John-K/ecp5-mini/hardware/0.1.1/ecp5-mini.pdf

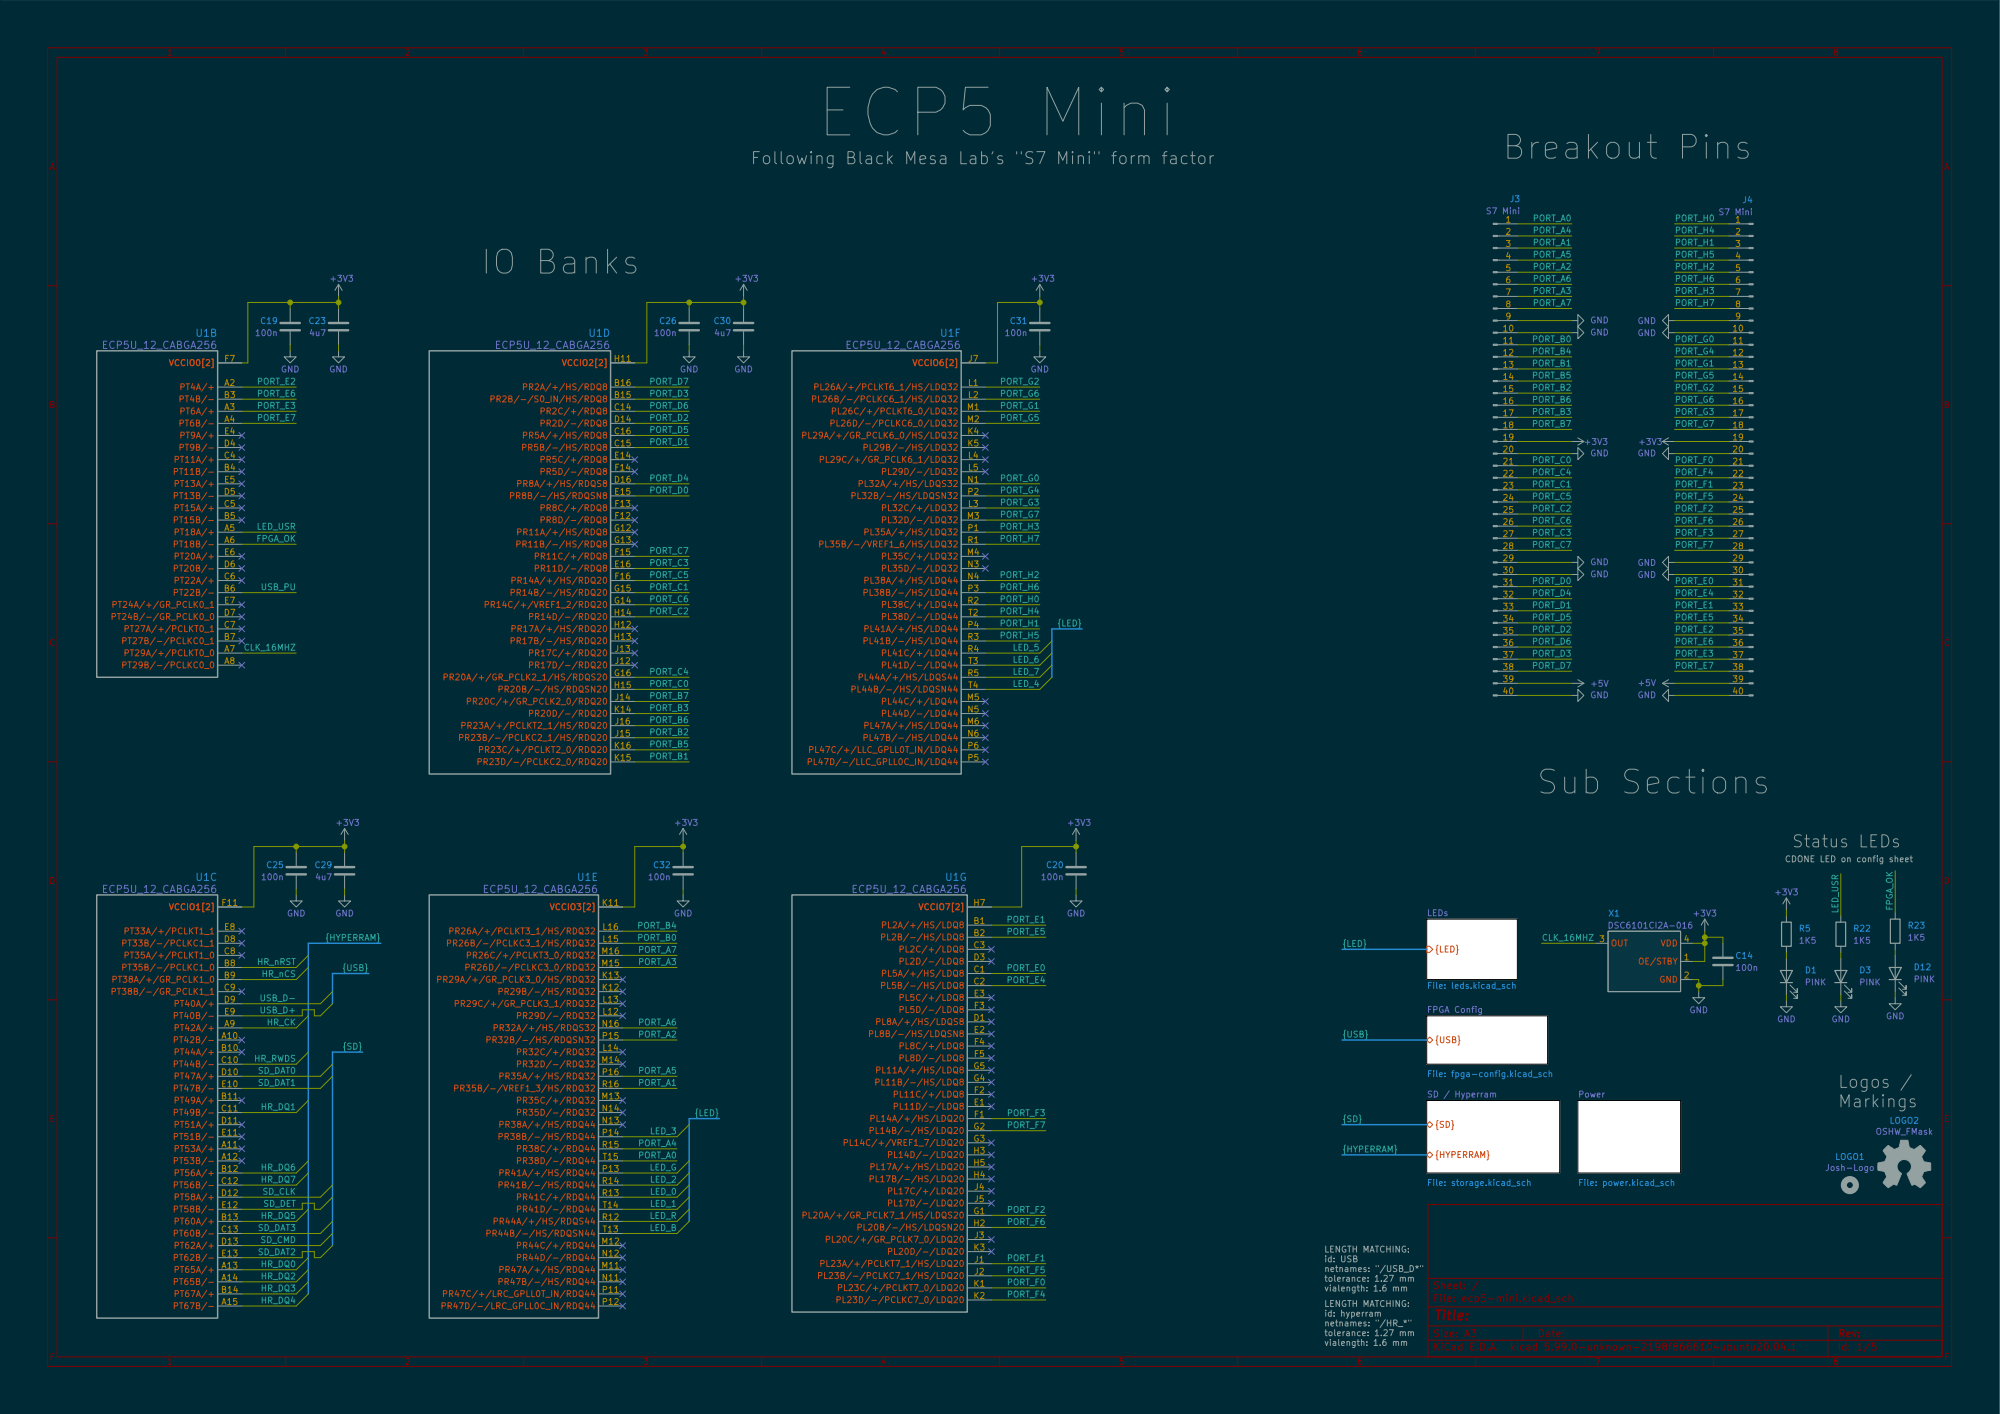
[picture p1: page 1]

Following Black Mesa Lab's "S7 Mini" form factor

CDONE LED on config sheet

{USB} LEDs File: leds.kicad_sch
File: ecp5-mini.kicad_sch Sheet: / FPGA Config

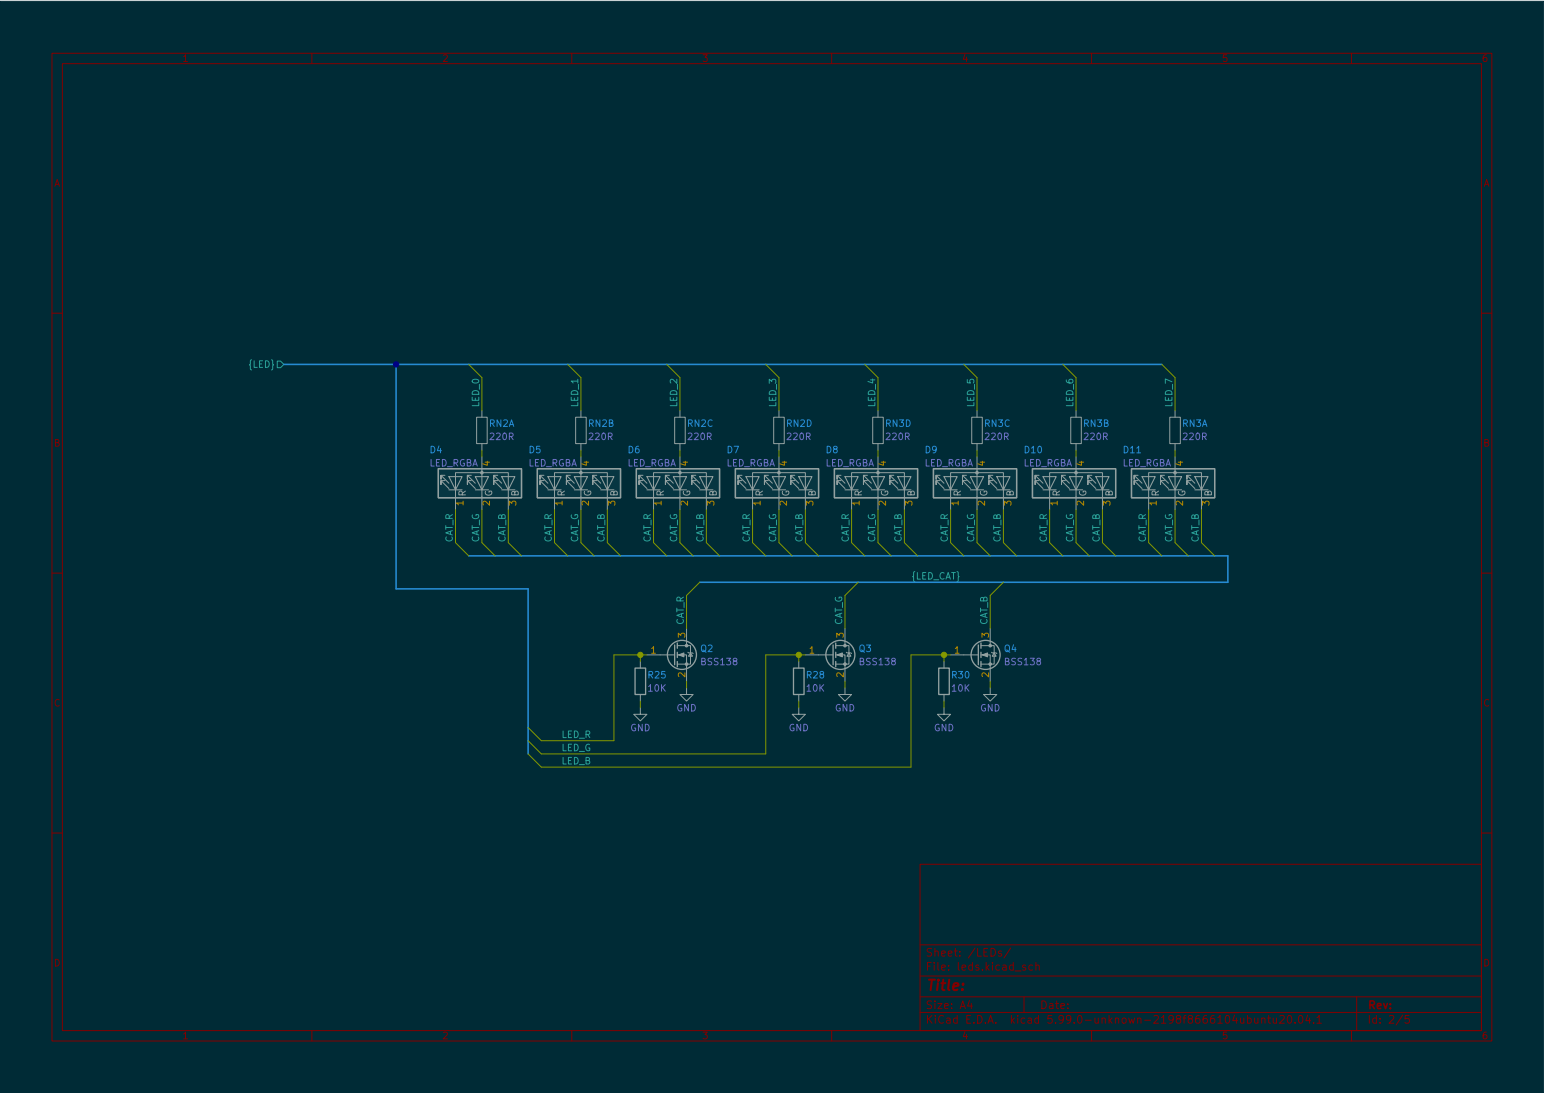
[picture p2: page 2]

2 3 Q3BSS138 GND
File: leds.kicad_sch Sheet: /LEDs/ GND

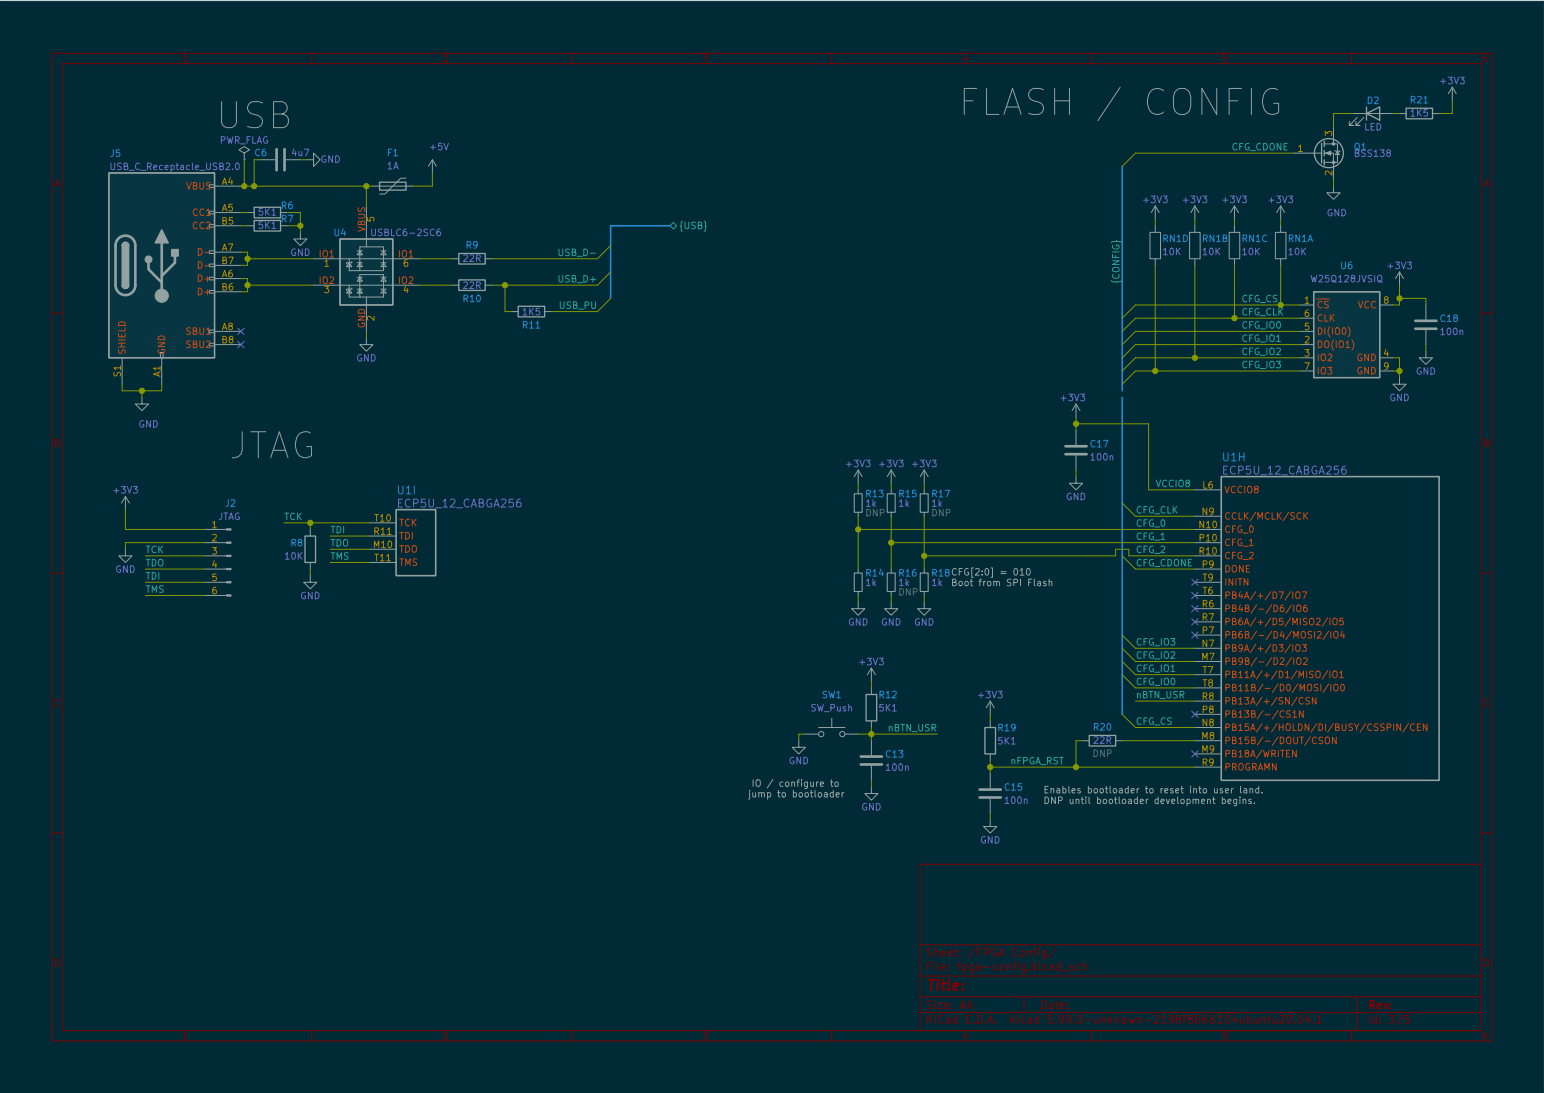
[picture p3: page 3]

CFG[2:0] = 010 Boot from SPI Flash Enables bootloader to reset into user land. DNP until bootloader development begins.

Sheet: /FPGA Config/ GND

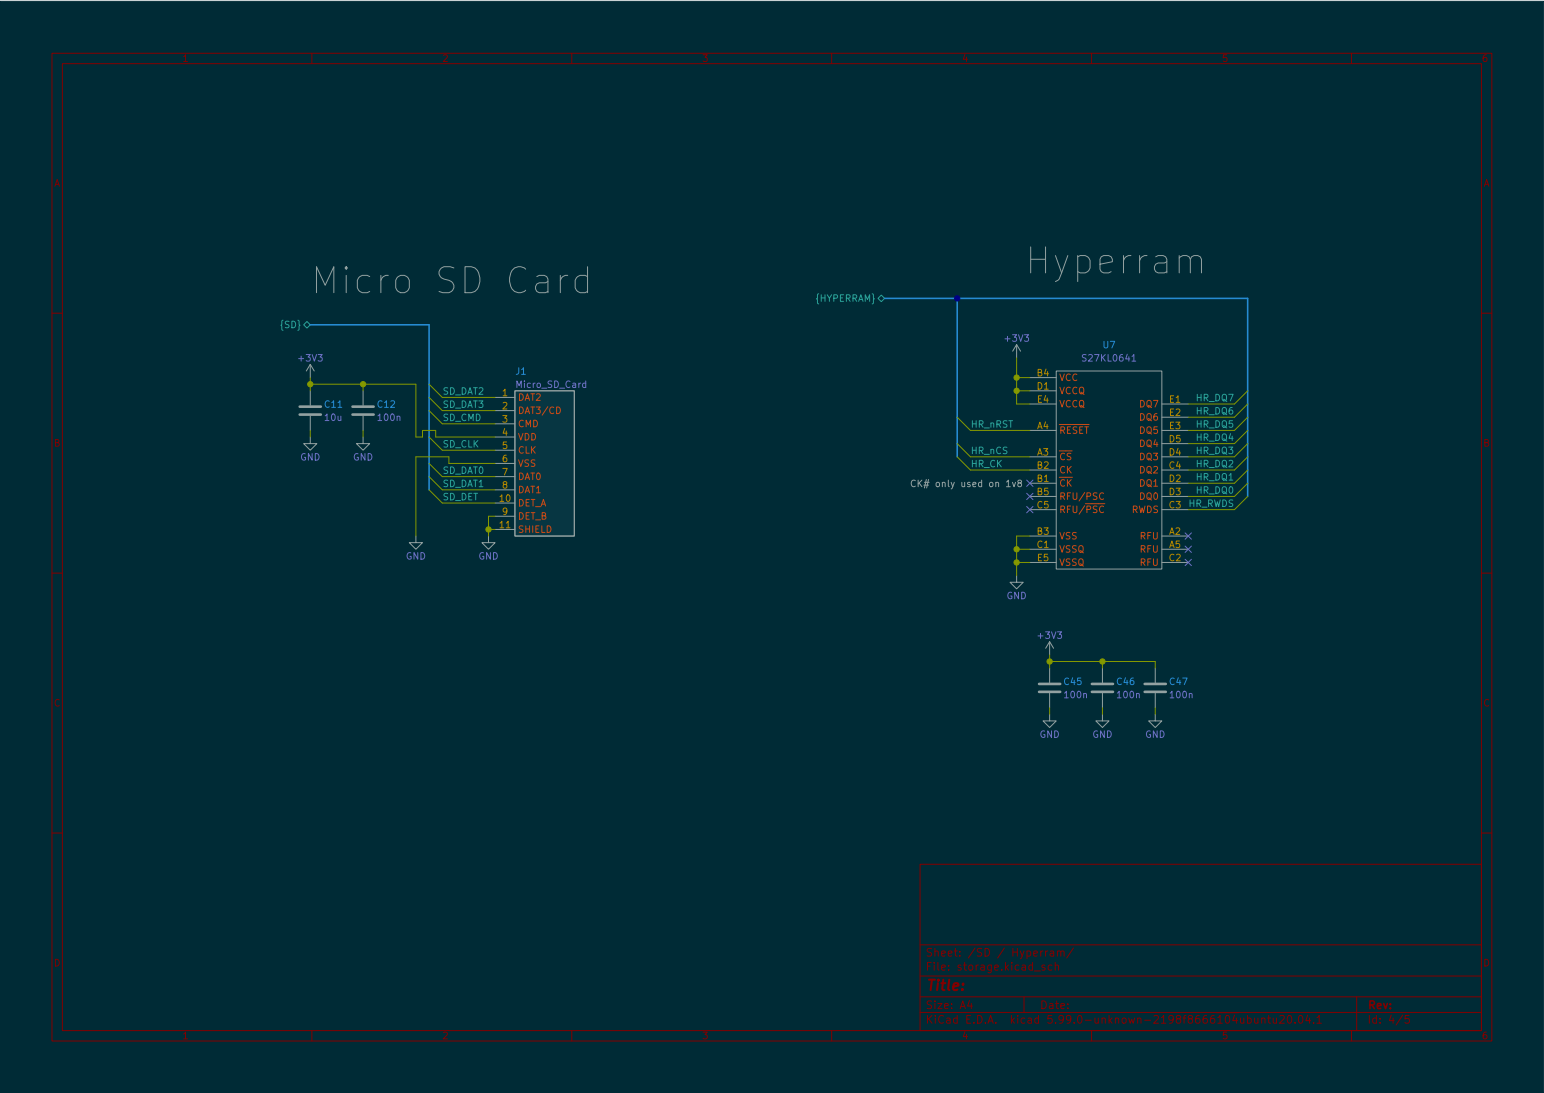
[picture p4: page 4]

CK# only used on 1v8

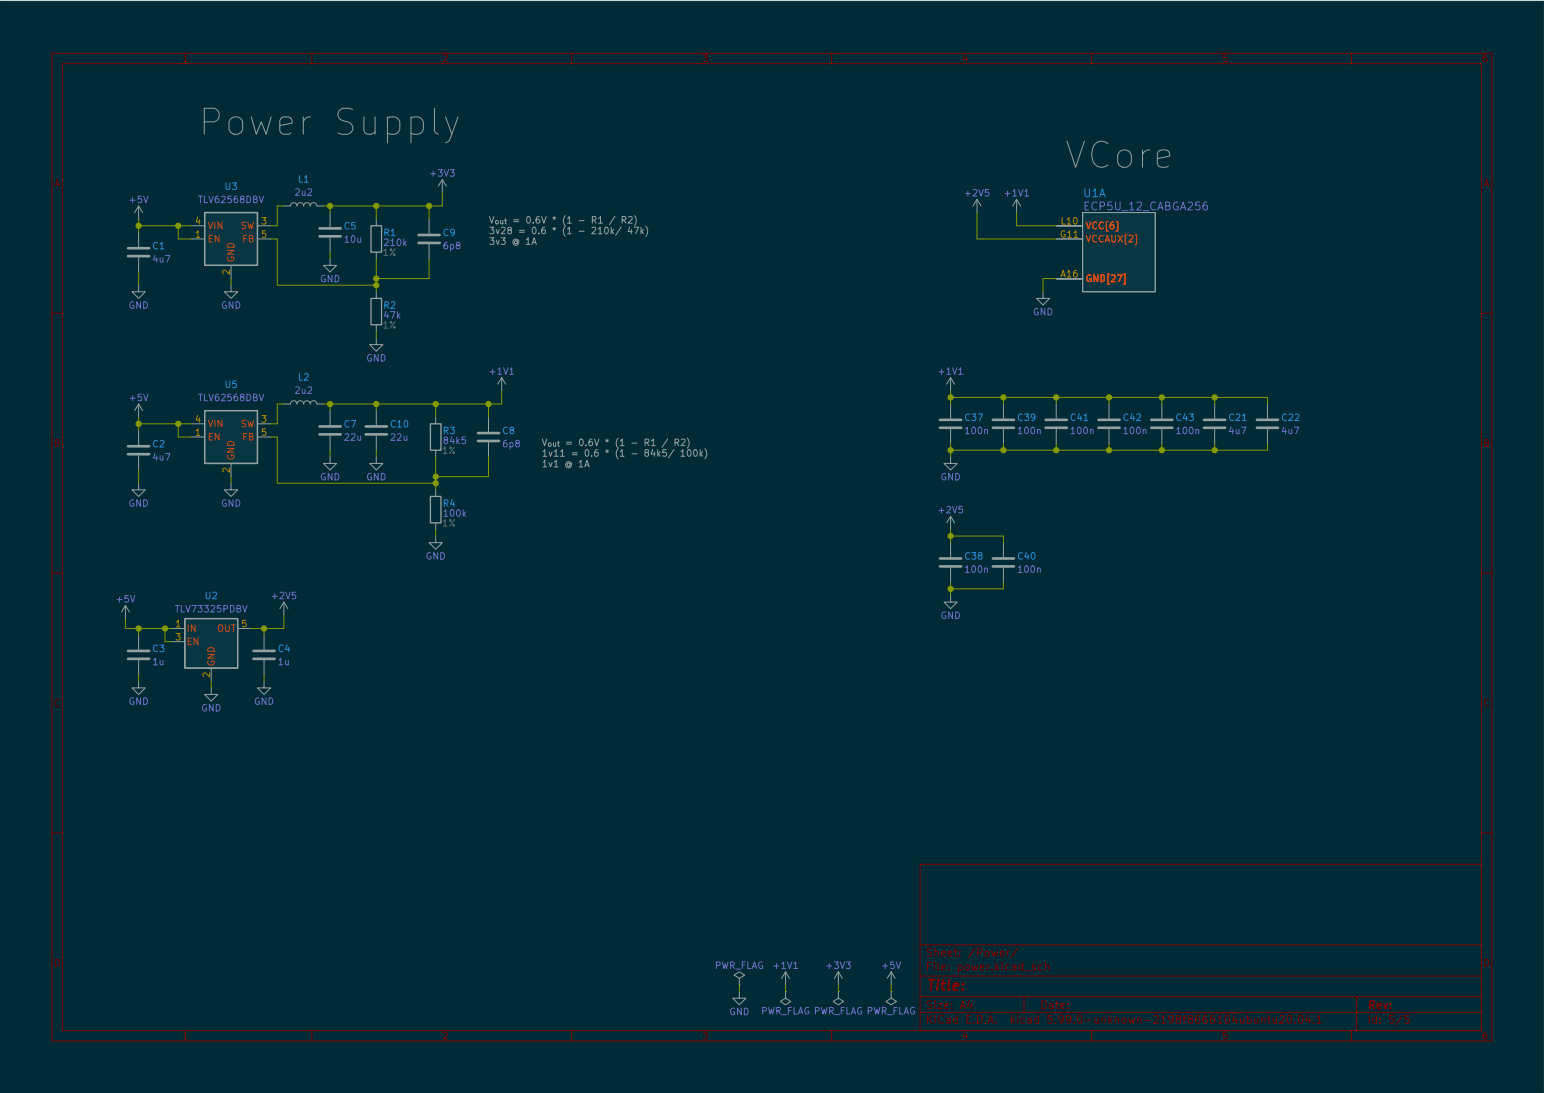
[picture p5: page 5]

2 SW 3 VIN 4 FB 5 U3 +5V TLV62568DBV +2V5 GND

File: power.kicad_sch Sheet: /Power/
Id: 5/5 Title:
