John-K/ecp5-mini/hardware/0.1.1/ecp5-mini.kicad_pcb

## KiCad design hardware/0.1.1/ecp5-mini.kicad_pcb (2020-12-09)

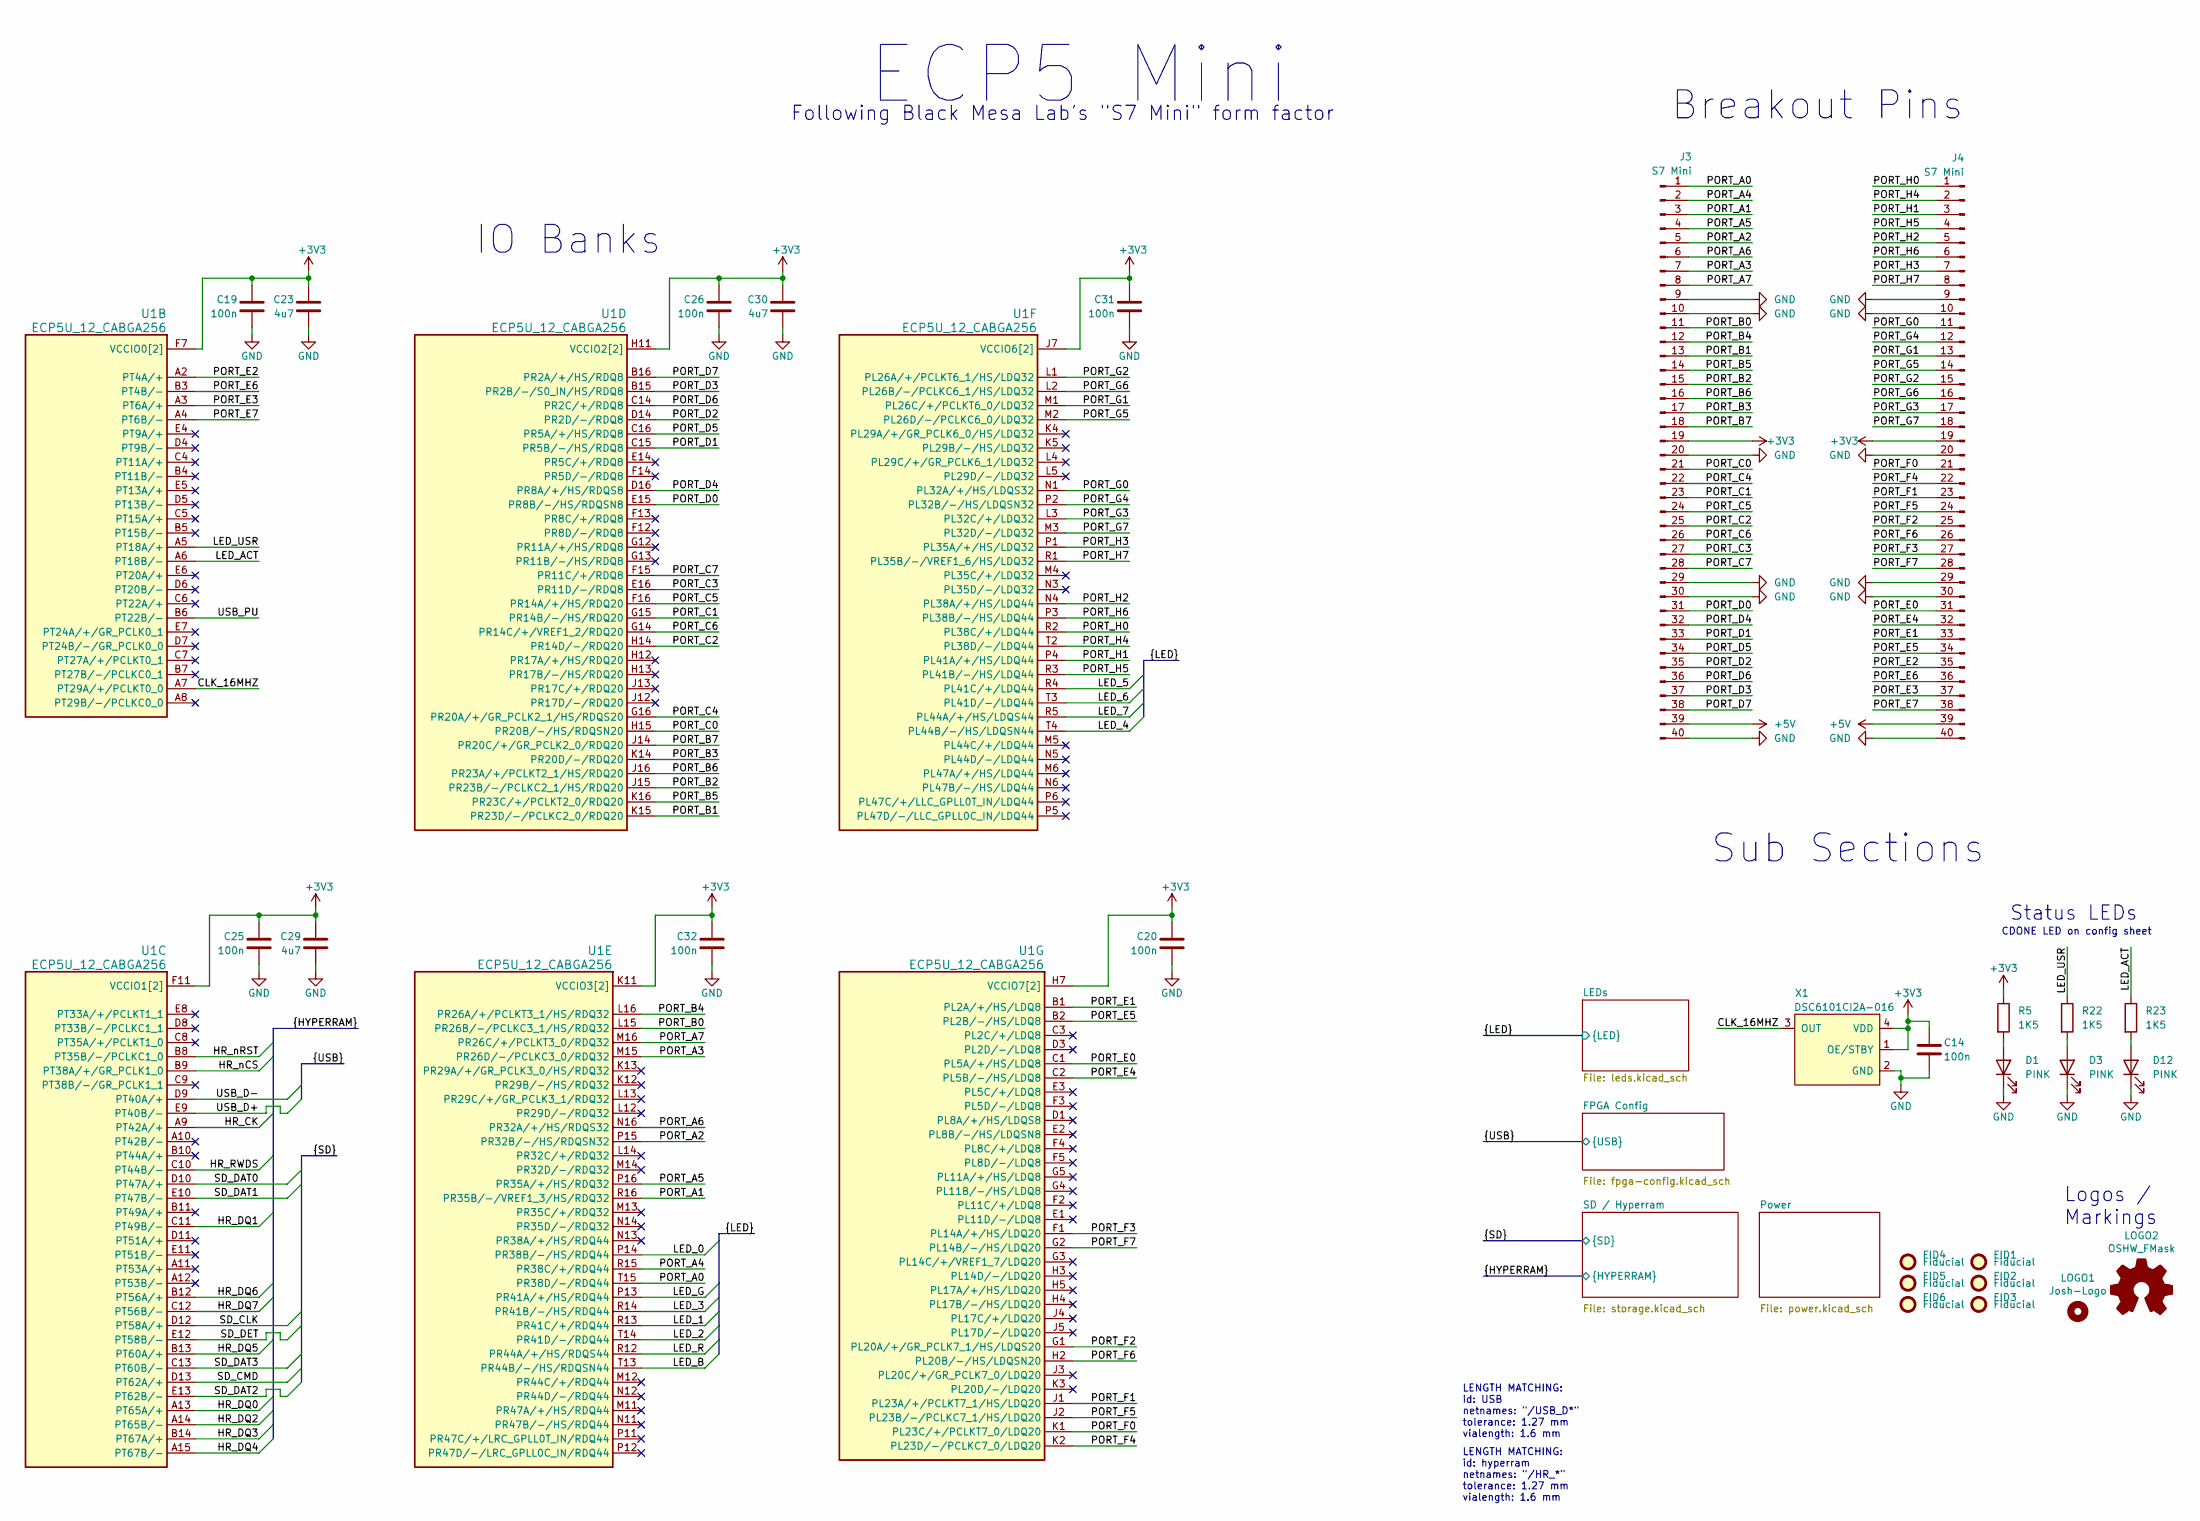
[picture p6: schematic ecp5-mini.kicad_sch]

Parts:
C14, C19, C20, C25, C26, C31, C32: 100n; C_0402_1005Metric; MPN CL05B104KO5NNNC; LCSC C1525
C23, C29, C30: 4u7; C_0402_1005Metric; MPN CL05A475KP5NRNC; LCSC C368809
D1, D3, D12: PINK; LED_0603_1608Metric; MPN OSK40603C1E; LCSC C268294
FID1, FID2, FID3, FID4, FID5, FID6: Fiducial; Fiducial_0.75mm_Mask1.5mm
J3, J4: S7 Mini; ECP5-Mini-Edge-20x2.54-40x1.27
LOGO1: Josh-Logo; josh-johnson-logo-8_6x1_5
LOGO2: OSHW_FMask; OSHW_Logo_3.6x3.6_F.Mask
R5, R22, R23: 1K5; R_0402_1005Metric; MPN 0402WGF1501TCE; LCSC C25867
U1: ECP5U_12_CABGA256; BGA-256_14.0x14.0mm_Layout16x16_P0.8mm_Ball0.45mm_Pad0.32mm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; MPN LFE5U12F8BG256C; Mouser 842-LFE5U12F8BG256C
X1: DSC6101CI2A-016; CDFN_3.2x2.5mm_XO; MPN DSC6101CI2A-016.0000; Mouser 579-101CI2A0160000

Connections:
+3V3: C14.1, C19.1, C20.1, C23.1, C25.1, C26.1, C29.1, C30.1, C31.1, C32.1, J3.19, J4.19, R5.1, U1.F6 (VCCIO0[2]), U1.F7 (VCCIO0[2]), U1.F10 (VCCIO1[2]), U1.F11 (VCCIO1[2]), U1.H6 (VCCIO7[2]), U1.H7 (VCCIO7[2]), U1.H11 (VCCIO2[2]), U1.J6 (VCCIO6[2]), U1.J7 (VCCIO6[2]), U1.J11 (VCCIO2[2]), U1.K11 (VCCIO3[2]), U1.L11 (VCCIO3[2]), X1.1 (OE/STBY), X1.4 (VDD); also elsewhere on the board
+5V: J3.39, J4.39; also elsewhere on the board
/CLK_16MHZ: U1.A7 (PT29A/+/PCLKT0_0), X1.3 (OUT)
/HR_CK: U1.A9 (PT42A/+); also elsewhere on the board
/HR_DQ0: U1.A13 (PT65A/+); also elsewhere on the board
/HR_DQ1: U1.C11 (PT49B/-); also elsewhere on the board
/HR_DQ2: U1.A14 (PT65B/-); also elsewhere on the board
/HR_DQ3: U1.B14 (PT67A/+); also elsewhere on the board
/HR_DQ4: U1.A15 (PT67B/-); also elsewhere on the board
/HR_DQ5: U1.B13 (PT60A/+); also elsewhere on the board
/HR_DQ6: U1.B12 (PT56A/+); also elsewhere on the board
/HR_DQ7: U1.C12 (PT56B/-); also elsewhere on the board
/HR_RWDS: U1.C10 (PT44B/-); also elsewhere on the board
/HR_nCS: U1.B9 (PT38A/+/GR_PCLK1_0); also elsewhere on the board
/HR_nRST: U1.B8 (PT35B/-/PCLKC1_0); also elsewhere on the board
/LED_0: U1.P14 (PR38B/-/HS/RDQ44); also elsewhere on the board
/LED_1: U1.R13 (PR41C/+/RDQ44); also elsewhere on the board
/LED_2: U1.T14 (PR41D/-/RDQ44); also elsewhere on the board
/LED_3: U1.R14 (PR41B/-/HS/RDQ44); also elsewhere on the board
/LED_4: U1.T4 (PL44B/-/HS/LDQSN44); also elsewhere on the board
/LED_5: U1.R4 (PL41C/+/LDQ44); also elsewhere on the board
/LED_6: U1.T3 (PL41D/-/LDQ44); also elsewhere on the board
/LED_7: U1.R5 (PL44A/+/HS/LDQS44); also elsewhere on the board
/LED_ACT: R23.1, U1.A6 (PT18B/-)
/LED_B: U1.T13 (PR44B/-/HS/RDQSN44); also elsewhere on the board
/LED_G: U1.P13 (PR41A/+/HS/RDQ44); also elsewhere on the board
/LED_R: U1.R12 (PR44A/+/HS/RDQS44); also elsewhere on the board
/LED_USR: R22.1, U1.A5 (PT18A/+)
/PORT_A0: J3.1, U1.T15 (PR38D/-/RDQ44)
/PORT_A1: J3.3, U1.R16 (PR35B/-/VREF1_3/HS/RDQ32)
/PORT_A2: J3.5, U1.P15 (PR32B/-/HS/RDQSN32)
/PORT_A3: J3.7, U1.M15 (PR26D/-/PCLKC3_0/RDQ32)
/PORT_A4: J3.2, U1.R15 (PR38C/+/RDQ44)
/PORT_A5: J3.4, U1.P16 (PR35A/+/HS/RDQ32)
/PORT_A6: J3.6, U1.N16 (PR32A/+/HS/RDQS32)
/PORT_A7: J3.8, U1.M16 (PR26C/+/PCLKT3_0/RDQ32)
/PORT_B0: J3.11, U1.L15 (PR26B/-/PCLKC3_1/HS/RDQ32)
/PORT_B1: J3.13, U1.K15 (PR23D/-/PCLKC2_0/RDQ20)
/PORT_B2: J3.15, U1.J15 (PR23B/-/PCLKC2_1/HS/RDQ20)
/PORT_B3: J3.17, U1.K14 (PR20D/-/RDQ20)
/PORT_B4: J3.12, U1.L16 (PR26A/+/PCLKT3_1/HS/RDQ32)
/PORT_B5: J3.14, U1.K16 (PR23C/+/PCLKT2_0/RDQ20)
/PORT_B6: J3.16, U1.J16 (PR23A/+/PCLKT2_1/HS/RDQ20)
/PORT_B7: J3.18, U1.J14 (PR20C/+/GR_PCLK2_0/RDQ20)
/PORT_C0: J3.21, U1.H15 (PR20B/-/HS/RDQSN20)
/PORT_C1: J3.23, U1.G15 (PR14B/-/HS/RDQ20)
/PORT_C2: J3.25, U1.H14 (PR14D/-/RDQ20)
/PORT_C3: J3.27, U1.E16 (PR11D/-/RDQ8)
/PORT_C4: J3.22, U1.G16 (PR20A/+/GR_PCLK2_1/HS/RDQS20)
/PORT_C5: J3.24, U1.F16 (PR14A/+/HS/RDQ20)
/PORT_C6: J3.26, U1.G14 (PR14C/+/VREF1_2/RDQ20)
/PORT_C7: J3.28, U1.F15 (PR11C/+/RDQ8)
/PORT_D0: J3.31, U1.E15 (PR8B/-/HS/RDQSN8)
/PORT_D1: J3.33, U1.C15 (PR5B/-/HS/RDQ8)
/PORT_D2: J3.35, U1.D14 (PR2D/-/RDQ8)
/PORT_D3: J3.37, U1.B15 (PR2B/-/S0_IN/HS/RDQ8)
/PORT_D4: J3.32, U1.D16 (PR8A/+/HS/RDQS8)
/PORT_D5: J3.34, U1.C16 (PR5A/+/HS/RDQ8)
/PORT_D6: J3.36, U1.C14 (PR2C/+/RDQ8)
/PORT_D7: J3.38, U1.B16 (PR2A/+/HS/RDQ8)
/PORT_E0: J4.31, U1.C1 (PL5A/+/HS/LDQ8)
/PORT_E1: J4.33, U1.B1 (PL2A/+/HS/LDQ8)
/PORT_E2: J4.35, U1.A2 (PT4A/+)
/PORT_E3: J4.37, U1.A3 (PT6A/+)
/PORT_E4: J4.32, U1.C2 (PL5B/-/HS/LDQ8)
/PORT_E5: J4.34, U1.B2 (PL2B/-/HS/LDQ8)
/PORT_E6: J4.36, U1.B3 (PT4B/-)
/PORT_E7: J4.38, U1.A4 (PT6B/-)
/PORT_F0: J4.21, U1.K1 (PL23C/+/PCLKT7_0/LDQ20)
/PORT_F1: J4.23, U1.J1 (PL23A/+/PCLKT7_1/HS/LDQ20)
/PORT_F2: J4.25, U1.G1 (PL20A/+/GR_PCLK7_1/HS/LDQS20)
/PORT_F3: J4.27, U1.F1 (PL14A/+/HS/LDQ20)
/PORT_F4: J4.22, U1.K2 (PL23D/-/PCLKC7_0/LDQ20)
/PORT_F5: J4.24, U1.J2 (PL23B/-/PCLKC7_1/HS/LDQ20)
/PORT_F6: J4.26, U1.H2 (PL20B/-/HS/LDQSN20)
/PORT_F7: J4.28, U1.G2 (PL14B/-/HS/LDQ20)
/PORT_G0: J4.11, U1.N1 (PL32A/+/HS/LDQS32)
/PORT_G1: J4.13, U1.M1 (PL26C/+/PCLKT6_0/LDQ32)
/PORT_G2: J4.15, U1.L1 (PL26A/+/PCLKT6_1/HS/LDQ32)
/PORT_G3: J4.17, U1.L3 (PL32C/+/LDQ32)
/PORT_G4: J4.12, U1.P2 (PL32B/-/HS/LDQSN32)
/PORT_G5: J4.14, U1.M2 (PL26D/-/PCLKC6_0/LDQ32)
/PORT_G6: J4.16, U1.L2 (PL26B/-/PCLKC6_1/HS/LDQ32)
/PORT_G7: J4.18, U1.M3 (PL32D/-/LDQ32)
/PORT_H0: J4.1, U1.R2 (PL38C/+/LDQ44)
/PORT_H1: J4.3, U1.P4 (PL41A/+/HS/LDQ44)
/PORT_H2: J4.5, U1.N4 (PL38A/+/HS/LDQ44)
/PORT_H3: J4.7, U1.P1 (PL35A/+/HS/LDQ32)
/PORT_H4: J4.2, U1.T2 (PL38D/-/LDQ44)
/PORT_H5: J4.4, U1.R3 (PL41B/-/HS/LDQ44)
/PORT_H6: J4.6, U1.P3 (PL38B/-/HS/LDQ44)
/PORT_H7: J4.8, U1.R1 (PL35B/-/VREF1_6/HS/LDQ32)
/SD_CLK: U1.D12 (PT58A/+); also elsewhere on the board
/SD_CMD: U1.D13 (PT62A/+); also elsewhere on the board
/SD_DAT0: U1.D10 (PT47A/+); also elsewhere on the board
/SD_DAT1: U1.E10 (PT47B/-); also elsewhere on the board
/SD_DAT2: U1.E13 (PT62B/-); also elsewhere on the board
/SD_DAT3: U1.C13 (PT60B/-); also elsewhere on the board
/SD_DET: U1.E12 (PT58B/-); also elsewhere on the board
/USB_D+: U1.E9 (PT40B/-); also elsewhere on the board
/USB_D-: U1.D9 (PT40A/+); also elsewhere on the board
/USB_PU: U1.B6 (PT22B/-); also elsewhere on the board
GND: C14.2, C19.2, C20.2, C23.2, C25.2, C26.2, C29.2, C30.2, C31.2, C32.2, D1.1 (K), D3.1 (K), D12.1 (K), J3.9, J3.10, J3.20, J3.29, J3.30, J3.40, J4.9, J4.10, J4.20, J4.29, J4.30, J4.40, X1.2 (GND); also elsewhere on the board
unnamed: D1.2 (A), R5.2
unnamed: D3.2 (A), R22.2
unnamed: D12.2 (A), R23.2

Notes on the sheet:
IO Banks
ECP5 Mini
Following Black Mesa Lab's "S7 Mini" form factor
LENGTH MATCHING: id: USB netnames: "/USB_D*" tolerance: 1.27 mm vialength: 1.6 mm
LENGTH MATCHING: id: hyperram netnames: "/HR_*" tolerance: 1.27 mm vialength: 1.6 mm
Breakout Pins
Sub Sections
Logos / Markings
Status LEDs
CDONE LED on config sheet

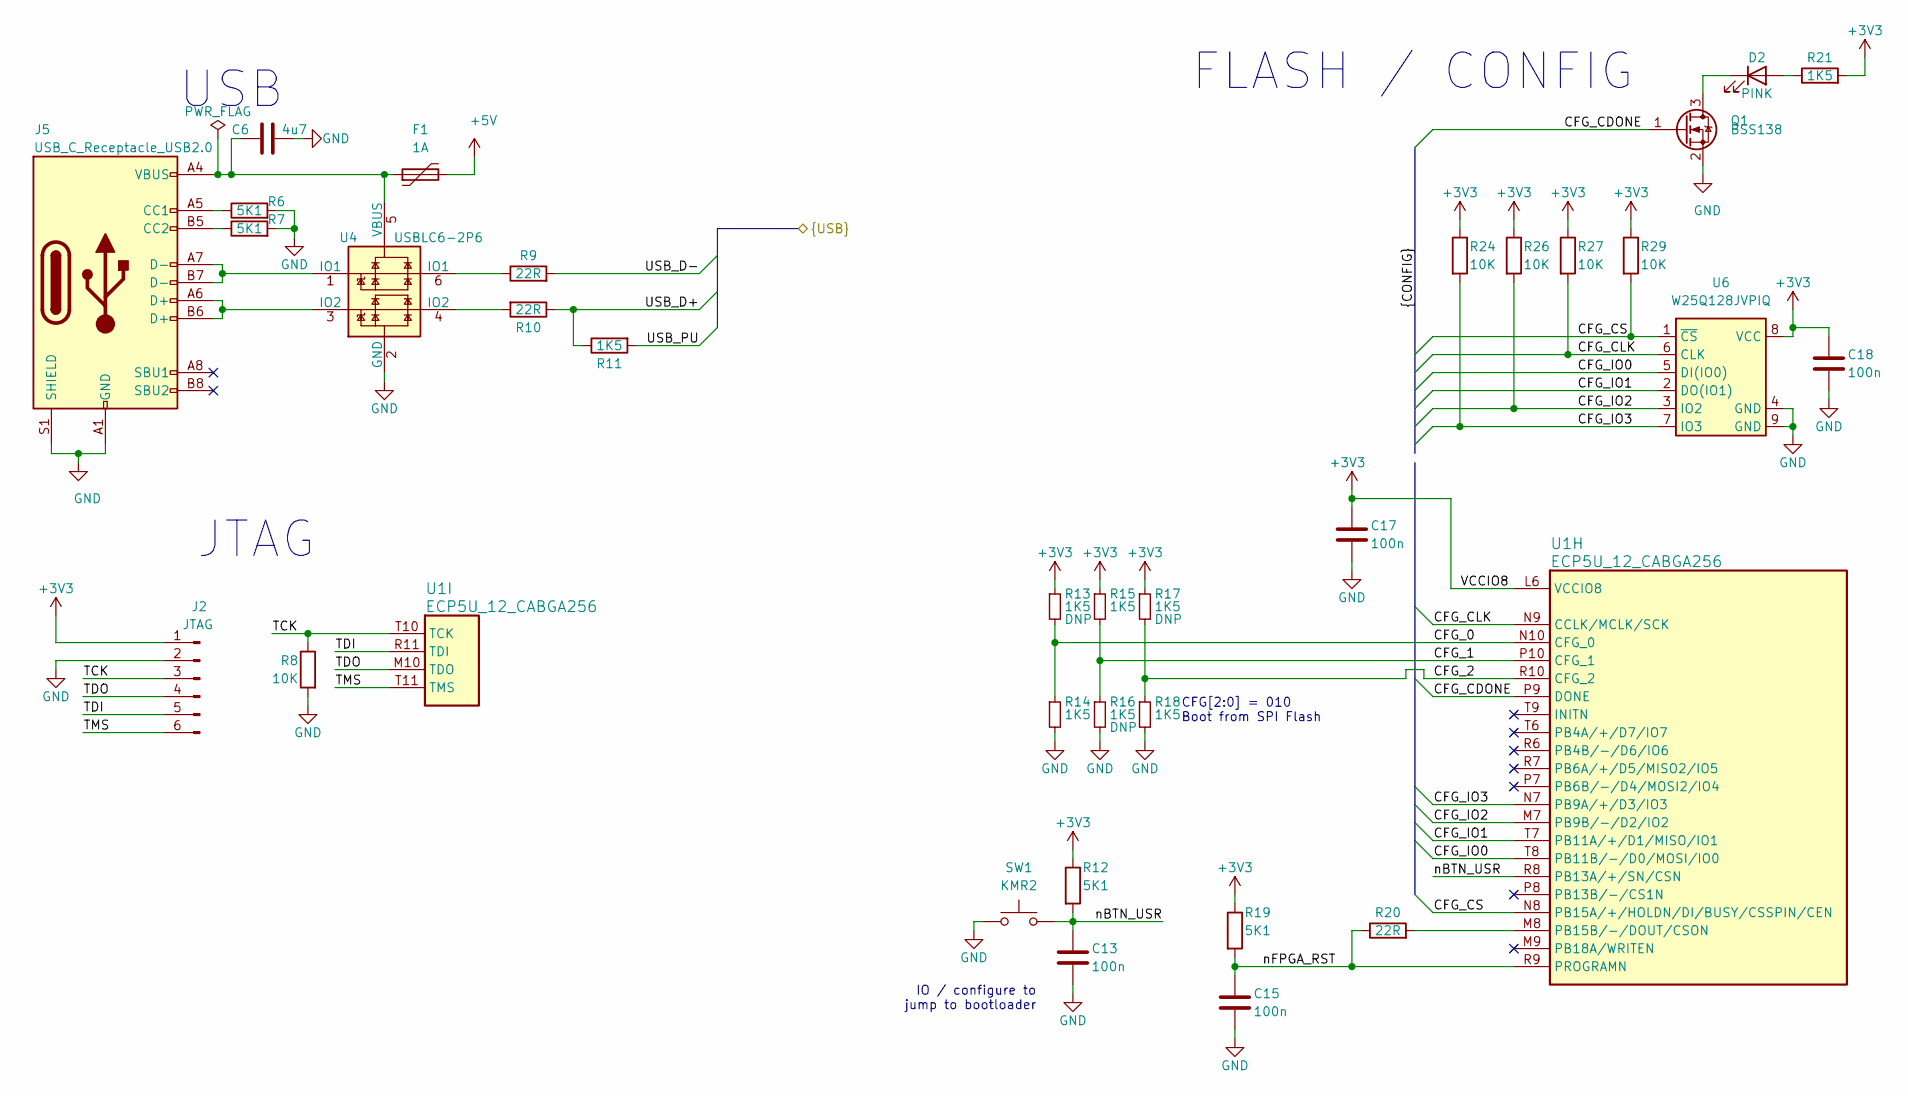
[picture p7: schematic fpga-config.kicad_sch]

Parts:
C6: 4u7; C_0603_1608Metric; MPN CL10A475KO8NNNC; LCSC C19666
C13, C15, C17, C18: 100n; C_0402_1005Metric; MPN CL05B104KO5NNNC; LCSC C1525
D2: PINK; LED_0603_1608Metric; MPN OSK40603C1E; LCSC C268294
F1: 1A; Fuse_0603_1608Metric; MPN 0603L100SLYR; LCSC C207017
J2: JTAG; STM_6_PIN_THT_Staggered
J5: USB_C_Receptacle_USB2.0; USB_C_Receptacle_HRO_TYPE-C-31-M-12; MPN TYPE-C-31-M-12; LCSC C165948
Q1: BSS138; SOT-323_SC-70; MPN BSS138PW,115; LCSC C193366
R6, R7, R12, R19: 5K1; R_0402_1005Metric; MPN 0402WGF5101TCE; LCSC C25905
R8, R24, R26, R27, R29: 10K; R_0402_1005Metric; MPN 0402WGJ0103TCE; LCSC C25531
R9, R10, R20: 22R; R_0402_1005Metric; MPN 0402WGJ0220TCE; LCSC C25152
R11, R13, R14, R15, R16, R17, R18, R21: 1K5; R_0402_1005Metric; MPN 0402WGF1501TCE; LCSC C25867
SW1: KMR2; SW_Push_KMR2; MPN TS-1185EC-C-D-B; LCSC C318893
U1: ECP5U_12_CABGA256; BGA-256_14.0x14.0mm_Layout16x16_P0.8mm_Ball0.45mm_Pad0.32mm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; MPN LFE5U12F8BG256C; Mouser 842-LFE5U12F8BG256C
U4: USBLC6-2P6; SOT-666; MPN USBLC6-2P6; LCSC C15999
U6: W25Q128JVPIQ; WSON-8-1EP_6x5mm_P1.27mm_EP3.4x4.3mm; MPN W25Q128JVPIQ; Mouser 454-W25Q128JVPIQ

Connections:
+3V3: C17.1, C18.1, J2.1, R12.1, R13.1, R15.1, R17.1, R19.1, R21.2, R24.1, R26.1, R27.1, R29.1, U1.L6 (VCCIO8), U6.8 (VCC); also elsewhere on the board
+5V: F1.2; also elsewhere on the board
/FPGA Config/CFG_0: R13.2, R14.1, U1.N10 (CFG_0)
/FPGA Config/CFG_1: R15.2, R16.1, U1.P10 (CFG_1)
/FPGA Config/CFG_2: R17.2, R18.1, U1.R10 (CFG_2)
/FPGA Config/CFG_CDONE: Q1.1 (G), U1.P9 (DONE)
/FPGA Config/CFG_CLK: R27.2, U1.N9 (CCLK/MCLK/SCK), U6.6 (CLK)
/FPGA Config/CFG_CS: R29.2, U1.N8 (PB15A/+/HOLDN/DI/BUSY/CSSPIN/CEN), U6.1 (~CS)
/FPGA Config/CFG_IO0: U1.T8 (PB11B/-/D0/MOSI/IO0), U6.5 (DI(IO0))
/FPGA Config/CFG_IO1: U1.T7 (PB11A/+/D1/MISO/IO1), U6.2 (DO(IO1))
/FPGA Config/CFG_IO2: R26.2, U1.M7 (PB9B/-/D2/IO2), U6.3 (IO2)
/FPGA Config/CFG_IO3: R24.2, U1.N7 (PB9A/+/D3/IO3), U6.7 (IO3)
/FPGA Config/TCK: J2.3, R8.1, U1.T10 (TCK)
/FPGA Config/TDI: J2.5, U1.R11 (TDI)
/FPGA Config/TDO: J2.4, U1.M10 (TDO)
/FPGA Config/TMS: J2.6, U1.T11 (TMS)
/FPGA Config/nBTN_USR: C13.1, R12.2, SW1.2, U1.R8 (PB13A/+/SN/CSN)
/FPGA Config/nFPGA_RST: C15.1, R19.2, R20.1, U1.R9 (PROGRAMN)
/USB_D+: R10.1, R11.1; also elsewhere on the board
/USB_D-: R9.2; also elsewhere on the board
/USB_PU: R11.2; also elsewhere on the board
GND: C6.2, C13.2, C15.2, C17.2, C18.2, J2.2, J5.A1 (GND), J5.A12 (GND), J5.B1 (GND), J5.B12 (GND), J5.S1 (SHIELD), Q1.2 (S), R6.2, R7.2, R8.2, R14.2, R16.2, R18.2, SW1.1, U4.2 (GND), U6.4 (GND), U6.9 (GND); also elsewhere on the board
unnamed: C6.1, F1.1, J5.A4 (VBUS), J5.A9 (VBUS), J5.B4 (VBUS), J5.B9 (VBUS), U4.5 (VBUS)
unnamed: D2.1 (K), Q1.3 (D)
unnamed: D2.2 (A), R21.1
unnamed: J5.A5 (CC1), R6.1
unnamed: J5.A6 (D+), J5.B6 (D+), U4.3 (IO2)
unnamed: J5.A7 (D-), J5.B7 (D-), U4.1 (IO1)
unnamed: J5.B5 (CC2), R7.1
unnamed: R9.1, U4.6 (IO1)
unnamed: R10.2, U4.4 (IO2)
unnamed: R20.2, U1.M8 (PB15B/-/DOUT/CSON)

Notes on the sheet:
USB
JTAG
IO / configure to jump to bootloader
CFG[2:0] = 010 Boot from SPI Flash
FLASH / CONFIG

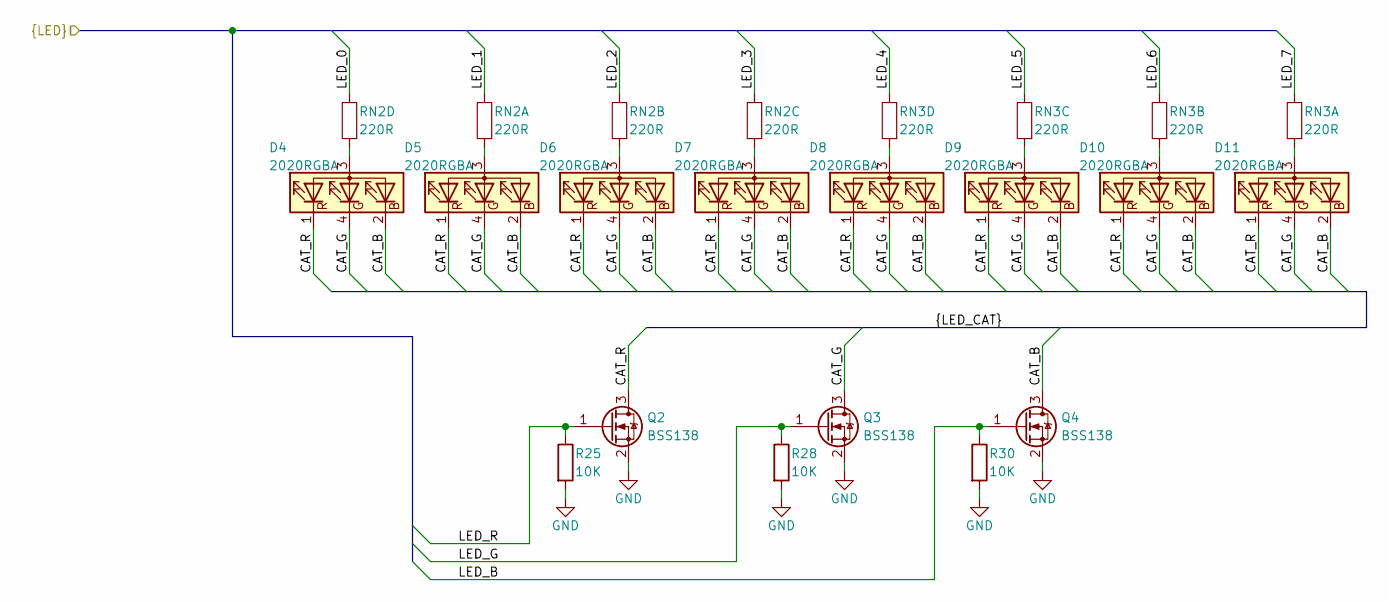
[picture p8: schematic leds.kicad_sch]

Parts:
D4, D5, D6, D7, D8, D9, D10, D11: 2020RGBA; LED_TRI_2020; MPN FM-B2020RGBA-HG
Q2, Q3, Q4: BSS138; SOT-323_SC-70; MPN BSS138PW,115; LCSC C193366
R25, R28, R30: 10K; R_0402_1005Metric; MPN 0402WGJ0103TCE; LCSC C25531
RN2, RN3: 220R; R_Array_Convex_4x0402; MPN 4D02WGJ0221TCE; LCSC C25498

Connections:
/LED_0: RN2.8; also elsewhere on the board
/LED_1: RN2.5; also elsewhere on the board
/LED_2: RN2.6; also elsewhere on the board
/LED_3: RN2.7; also elsewhere on the board
/LED_4: RN3.8; also elsewhere on the board
/LED_5: RN3.7; also elsewhere on the board
/LED_6: RN3.6; also elsewhere on the board
/LED_7: RN3.5; also elsewhere on the board
/LED_B: Q4.1 (G), R30.1; also elsewhere on the board
/LED_G: Q3.1 (G), R28.1; also elsewhere on the board
/LED_R: Q2.1 (G), R25.1; also elsewhere on the board
/LEDs/CAT_B: D4.2 (BK), D5.2 (BK), D6.2 (BK), D7.2 (BK), D8.2 (BK), D9.2 (BK), D10.2 (BK), D11.2 (BK), Q4.3 (D)
/LEDs/CAT_G: D4.4 (GK), D5.4 (GK), D6.4 (GK), D7.4 (GK), D8.4 (GK), D9.4 (GK), D10.4 (GK), D11.4 (GK), Q3.3 (D)
/LEDs/CAT_R: D4.1 (RK), D5.1 (RK), D6.1 (RK), D7.1 (RK), D8.1 (RK), D9.1 (RK), D10.1 (RK), D11.1 (RK), Q2.3 (D)
GND: Q2.2 (S), Q3.2 (S), Q4.2 (S), R25.2, R28.2, R30.2; also elsewhere on the board
unnamed: D4.3 (A), RN2.1
unnamed: D5.3 (A), RN2.4
unnamed: D6.3 (A), RN2.3
unnamed: D7.3 (A), RN2.2
unnamed: D8.3 (A), RN3.1
unnamed: D9.3 (A), RN3.2
unnamed: D10.3 (A), RN3.3
unnamed: D11.3 (A), RN3.4

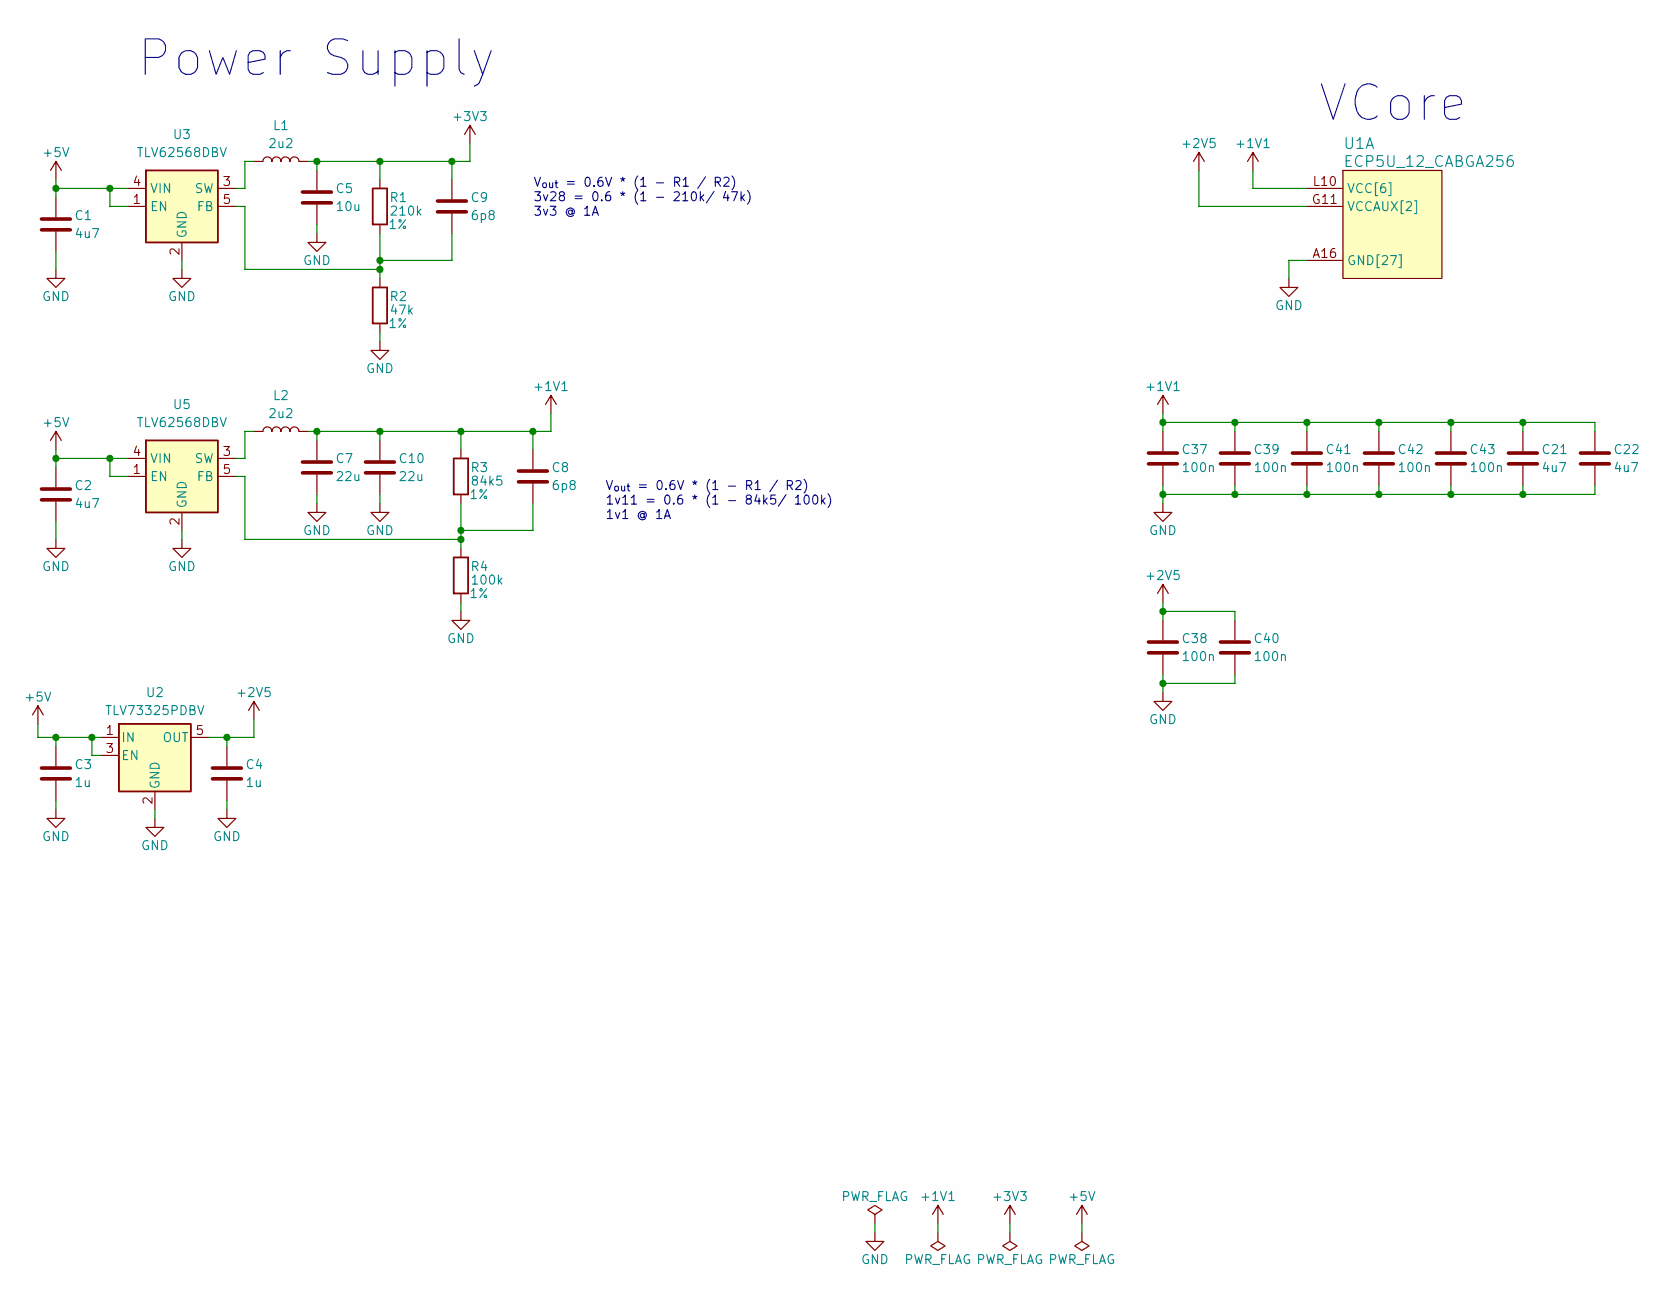
[picture p9: schematic power.kicad_sch]

Parts:
C1, C2: 4u7; C_0603_1608Metric; MPN CL10A475KO8NNNC; LCSC C19666
C3, C4: 1u; C_0603_1608Metric; MPN CL10A105KA8NNNC; LCSC C5673
C5: 10u; C_0603_1608Metric; MPN CL10A106MO8NQNC; LCSC C92487
C7, C10: 22u; C_0603_1608Metric
C8, C9: 6p8; C_0402_1005Metric; MPN CL05C6R8DB5NNNC; LCSC C86292
C21, C22: 4u7; C_0402_1005Metric; MPN CL05A475KP5NRNC; LCSC C368809
C37, C38, C39, C40, C41, C42, C43: 100n; C_0402_1005Metric; MPN CL05B104KO5NNNC; LCSC C1525
L1, L2: 2u2; L_0805_2012Metric; MPN SLM20122R2MIT; LCSC C216156
R1: 210k; R_0402_1005Metric; Tolerance 1%; MPN 0402WGF2103TCE; LCSC C58827
R2: 47k; R_0402_1005Metric; Tolerance 1%; MPN 0402WGF4702TCE; LCSC C25792
R3: 84k5; R_0402_1005Metric; Tolerance 1%; MPN 0402WGF8452TCE; LCSC C26988
R4: 100k; R_0402_1005Metric; Tolerance 1%; MPN 0402WGF1003TCE; LCSC C25741
U1: ECP5U_12_CABGA256; BGA-256_14.0x14.0mm_Layout16x16_P0.8mm_Ball0.45mm_Pad0.32mm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; MPN LFE5U12F8BG256C; Mouser 842-LFE5U12F8BG256C
U2: TLV73325PDBV; SOT-23-5; MPN TLV73325PDBVR; Mouser 595-TLV73325PDBVR
U3, U5: TLV62568DBV; SOT-23-5; MPN TLV62568DBVR; LCSC C163219

Connections:
+1V1: C7.1, C8.1, C10.1, C21.1, C22.1, C37.1, C39.1, C41.1, C42.1, C43.1, L2.2, R3.1, U1.G6 (VCC[6]), U1.G7 (VCC[6]), U1.G9 (VCC[6]), U1.L8 (VCC[6]), U1.L9 (VCC[6]), U1.L10 (VCC[6])
+2V5: C4.1, C38.1, C40.1, U1.G11 (VCCAUX[2]), U1.L7 (VCCAUX[2]), U2.5 (OUT)
+3V3: C5.1, C9.1, L1.2, R1.1; also elsewhere on the board
+5V: C1.1, C2.1, C3.1, U2.1 (IN), U2.3 (EN), U3.1 (EN), U3.4 (VIN), U5.1 (EN), U5.4 (VIN); also elsewhere on the board
GND: C1.2, C2.2, C3.2, C4.2, C5.2, C7.2, C10.2, C21.2, C22.2, C37.2, C38.2, C39.2, C40.2, C41.2, C42.2, C43.2, R2.2, R4.2, U1.A1 (GND[27]), U1.A16 (GND[27]), U1.D2 (GND[27]), U1.D15 (GND[27]), U1.F8 (GND[27]), U1.F9 (GND[27]), U1.G8 (GND[27]), U1.G10 (GND[27]), U1.H1 (GND[27]), U1.H8 (GND[27]), U1.H9 (GND[27]), U1.H10 (GND[27]), U1.H16 (GND[27]), U1.J8 (GND[27]), U1.J9 (GND[27]), U1.J10 (GND[27]), U1.K6 (GND[27]), U1.K7 (GND[27]), U1.K8 (GND[27]), U1.K9 (GND[27]), U1.K10 (GND[27]), U1.N2 (GND[27]), U1.N15 (GND[27]), U1.T1 (GND[27]), U1.T5 (GND[27]), U1.T12 (GND[27]), U1.T16 (GND[27]), U2.2 (GND), U3.2 (GND), U5.2 (GND); also elsewhere on the board
unnamed: C8.2, R3.2, R4.1, U5.5 (FB)
unnamed: C9.2, R1.2, R2.1, U3.5 (FB)
unnamed: L1.1, U3.3 (SW)
unnamed: L2.1, U5.3 (SW)

Notes on the sheet:
Power Supply
V_{out} = 0.6V * (1 - R1 / R2) 3v28 = 0.6 * (1 - 210k/ 47k) 3v3 @ 1A
V_{out} = 0.6V * (1 - R1 / R2) 1v11 = 0.6 * (1 - 84k5/ 100k) 1v1 @ 1A
VCore

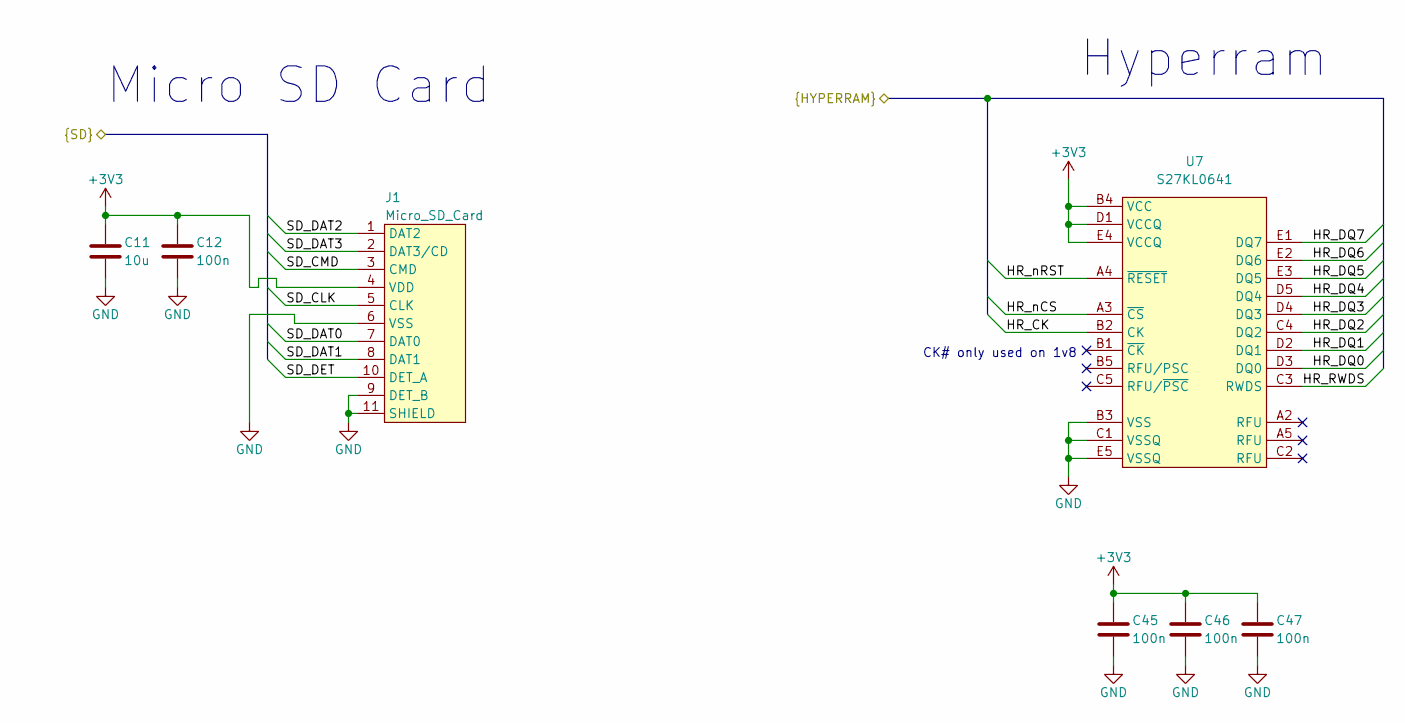
[picture p10: schematic storage.kicad_sch]

Parts:
C11: 10u; C_0603_1608Metric; MPN CL10A106MO8NQNC; LCSC C92487
C12, C45, C46, C47: 100n; C_0402_1005Metric; MPN CL05B104KO5NNNC; LCSC C1525
J1: Micro_SD_Card; microSD_HC_Molex_104031-0811; MPN 104031-0811; Mouser 538-104031-0811
U7: S27KL0641; BGA-24_5x5_6.0x8.0mm; MPN S27KL0641; Mouser 727-S27KL0641DABHI02

Connections:
+3V3: C11.1, C12.1, C45.1, C46.1, C47.1, J1.4 (VDD), U7.B4 (VCC), U7.D1 (VCCQ), U7.E4 (VCCQ); also elsewhere on the board
/HR_CK: U7.B2 (CK); also elsewhere on the board
/HR_DQ0: U7.D3 (DQ0); also elsewhere on the board
/HR_DQ1: U7.D2 (DQ1); also elsewhere on the board
/HR_DQ2: U7.C4 (DQ2); also elsewhere on the board
/HR_DQ3: U7.D4 (DQ3); also elsewhere on the board
/HR_DQ4: U7.D5 (DQ4); also elsewhere on the board
/HR_DQ5: U7.E3 (DQ5); also elsewhere on the board
/HR_DQ6: U7.E2 (DQ6); also elsewhere on the board
/HR_DQ7: U7.E1 (DQ7); also elsewhere on the board
/HR_RWDS: U7.C3 (RWDS); also elsewhere on the board
/HR_nCS: U7.A3 (~CS); also elsewhere on the board
/HR_nRST: U7.A4 (~RESET); also elsewhere on the board
/SD_CLK: J1.5 (CLK); also elsewhere on the board
/SD_CMD: J1.3 (CMD); also elsewhere on the board
/SD_DAT0: J1.7 (DAT0); also elsewhere on the board
/SD_DAT1: J1.8 (DAT1); also elsewhere on the board
/SD_DAT2: J1.1 (DAT2); also elsewhere on the board
/SD_DAT3: J1.2 (DAT3/CD); also elsewhere on the board
/SD_DET: J1.10 (DET_A); also elsewhere on the board
GND: C11.2, C12.2, C45.2, C46.2, C47.2, J1.6 (VSS), J1.9 (DET_B), J1.11 (SHIELD), U7.B3 (VSS), U7.C1 (VSSQ), U7.E5 (VSSQ); also elsewhere on the board

Notes on the sheet:
Micro SD Card
CK# only used on 1v8
Hyperram

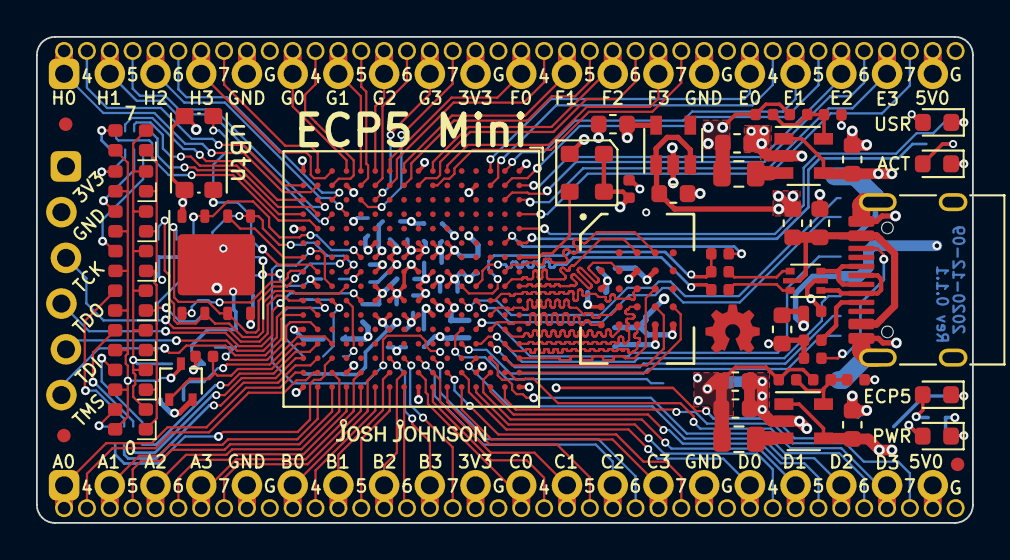
[picture p11: board ecp5-mini.kicad_pcb from above]

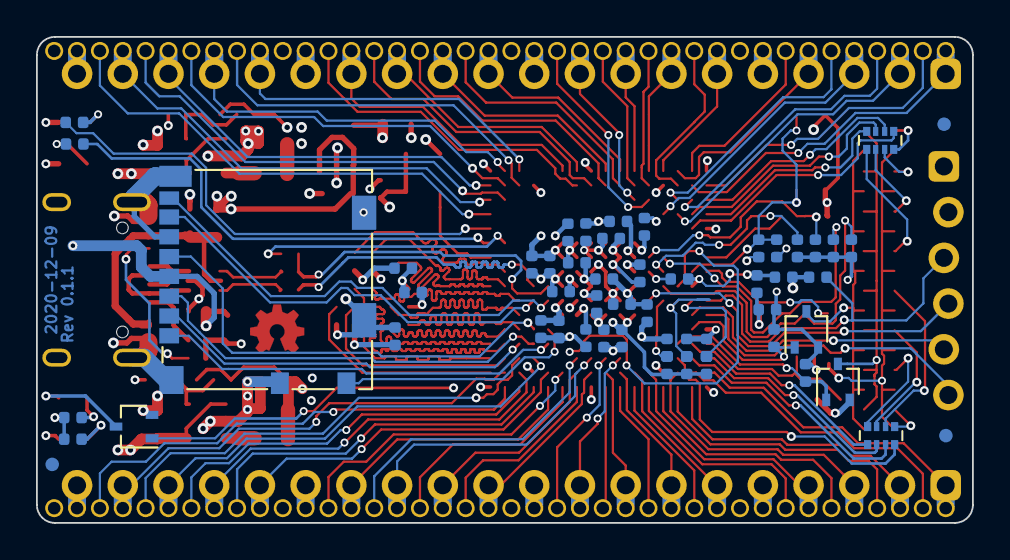
[picture p12: board ecp5-mini.kicad_pcb from below]

Board: 4 copper layers, 52.0 x 27.0 mm, 111 parts (55 on the bottom side), 149 nets.
