John-K/ecp5-mini/(commit log)

2020-12-09 Resolve T12 via issue and feng-shui some traces
    [ecp5-mini.kicad_pcb, ecp5-mini.kicad_sch, ecp5-mini.sch, fpga-config.kicad_sch, leds.kicad_sch, power.kicad_sch, storage.kicad_sch]
2020-12-09 Update board date and version
    [ecp5-mini.kicad_pcb]
